lesterjessh/Arduino-based-3D-Scanner-Using-an-IR-Analog-Distance-Sensor/README.md

# Arduino-based Point Cloud Scanner Using an Infrared Analog Distance Sensor (Sharp GP2Y0A41SK0F, 4-30cm)
### System Design
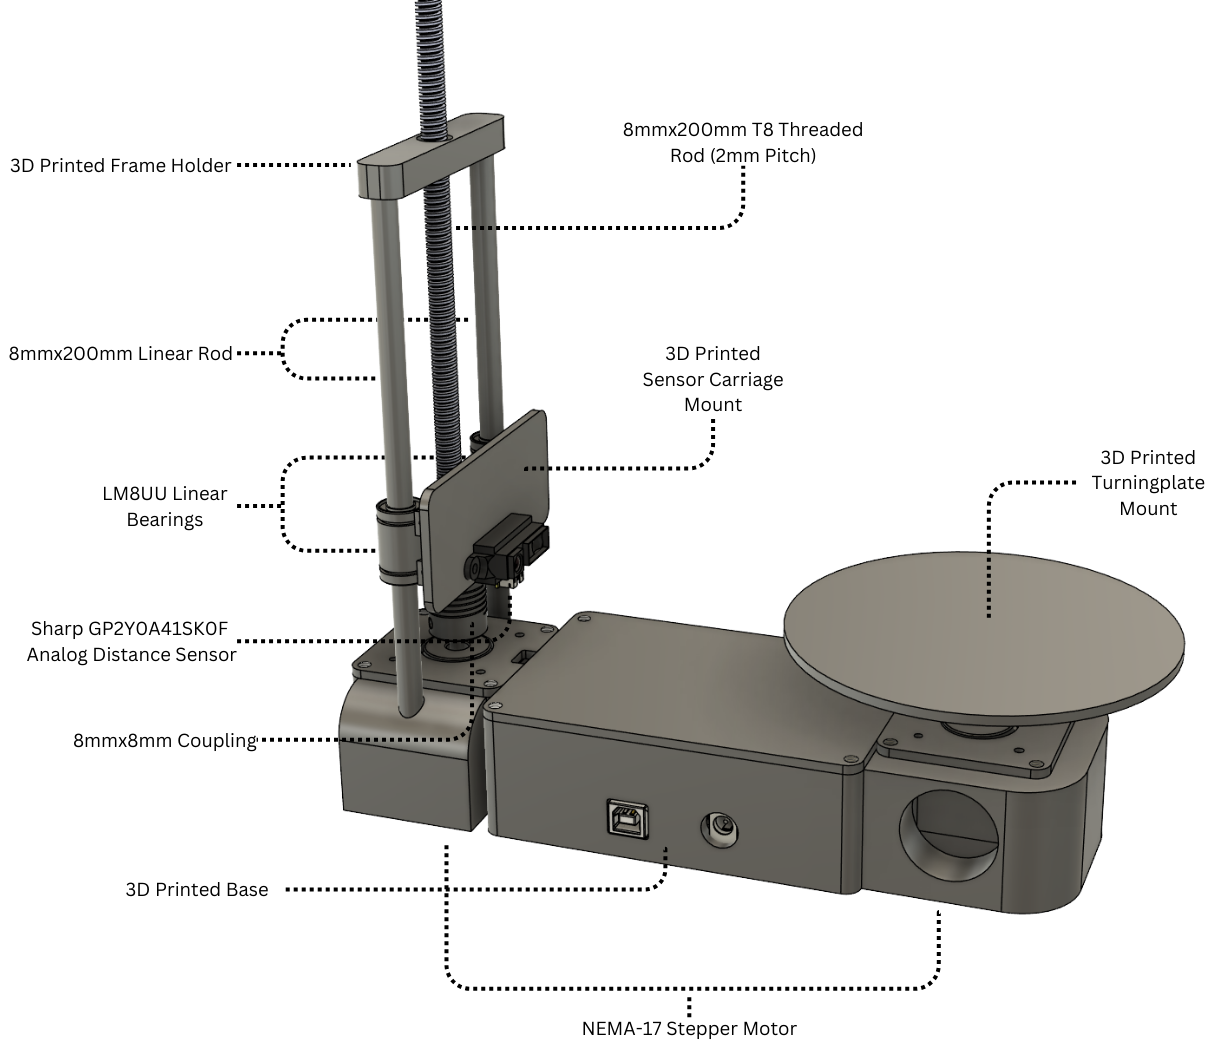
[picture p1: system_design.png]
Design

### Functional Prototype
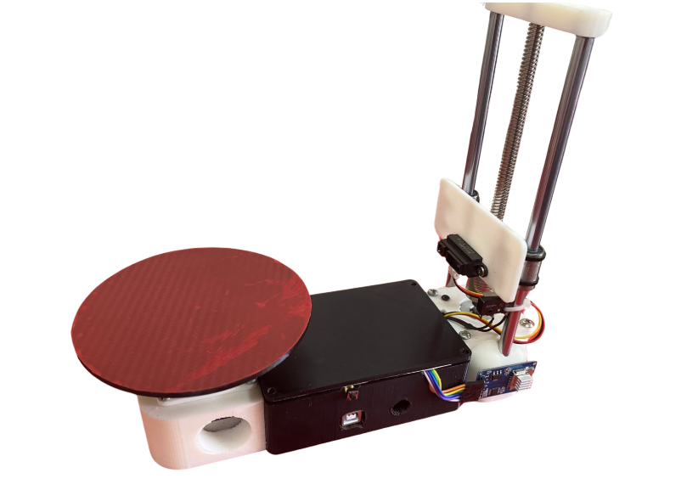
[picture p2: prototype.png]
Prototype

### Program Flow
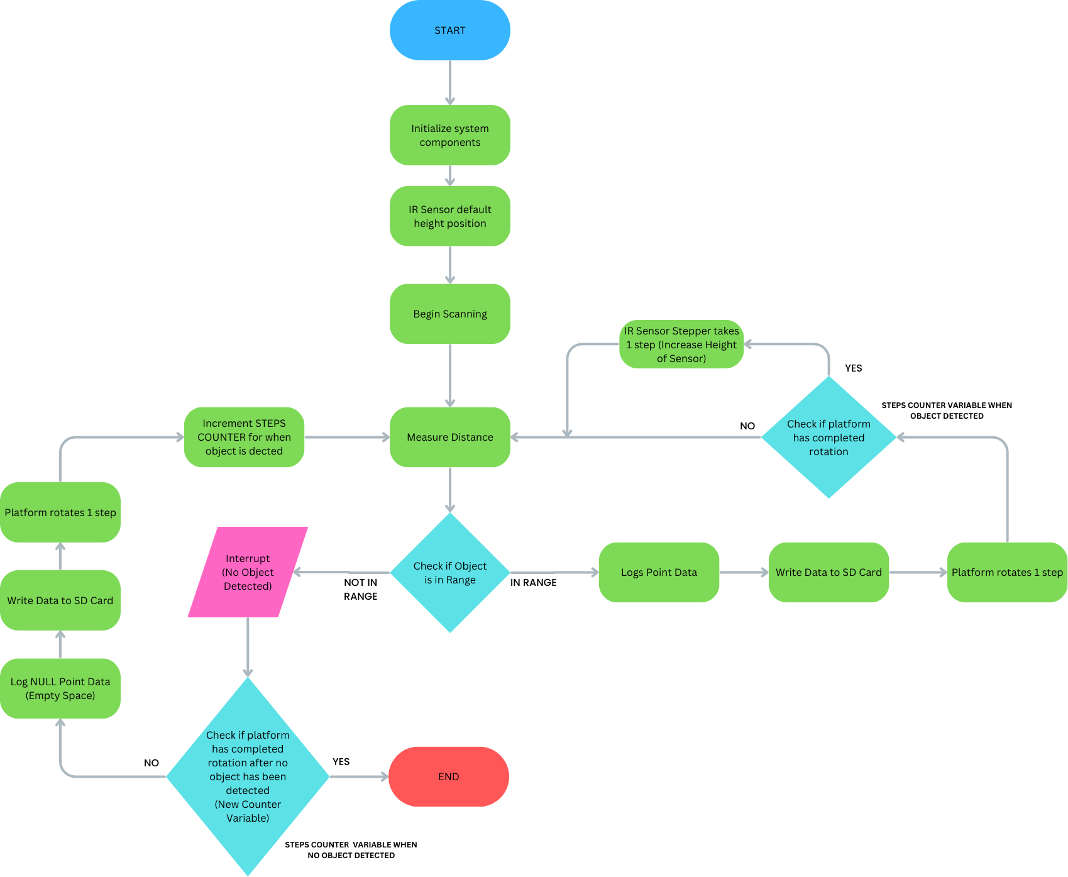
[picture p3: program_flow.png]
Program
